Pavlik/STM32-WS2812B-Lamp/images/pcb-back-render.png

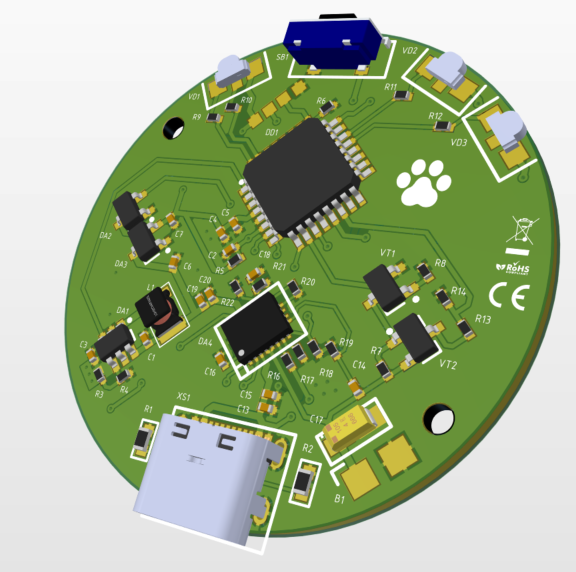
images/pcb-back-render.png
