Pavlik/STM32-WS2812B-Lamp/hardware/PCB/pics/ce.png

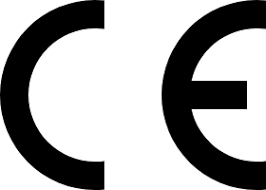
hardware/PCB/pics/ce.png
