Pavlik/STM32-WS2812B-Lamp/hardware/PCB/pics/paw.png

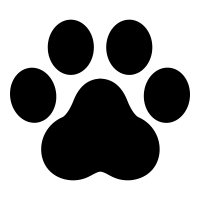
hardware/PCB/pics/paw.png
