Pavlik/STM32-WS2812B-Lamp/hardware/PCB/pics/rohs.png

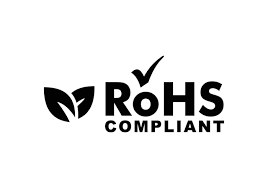
hardware/PCB/pics/rohs.png
