Pavlik/STM32-WS2812B-Lamp/hardware/PCB/pics/weee.png

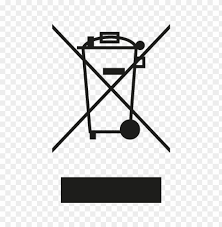
hardware/PCB/pics/weee.png
