Pavlik/STM32-WS2812B-Lamp/images/device-render-1.png

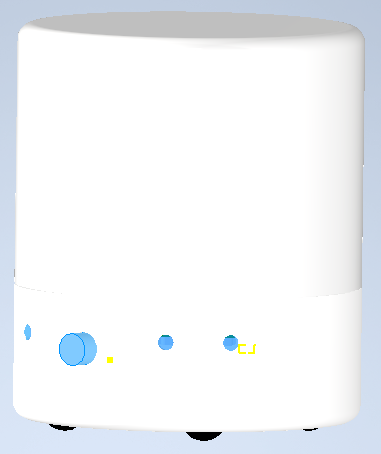
images/device-render-1.png
