Pavlik/STM32-WS2812B-Lamp/images/device-render-2.png

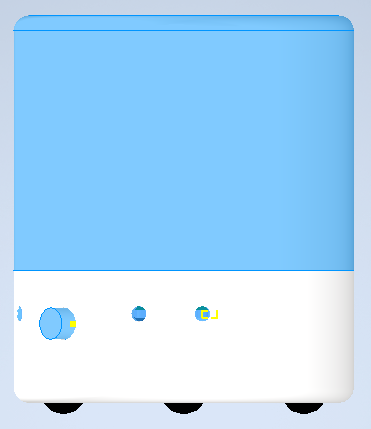
images/device-render-2.png
