Pavlik/STM32-WS2812B-Lamp/images/pcb-front-render.png

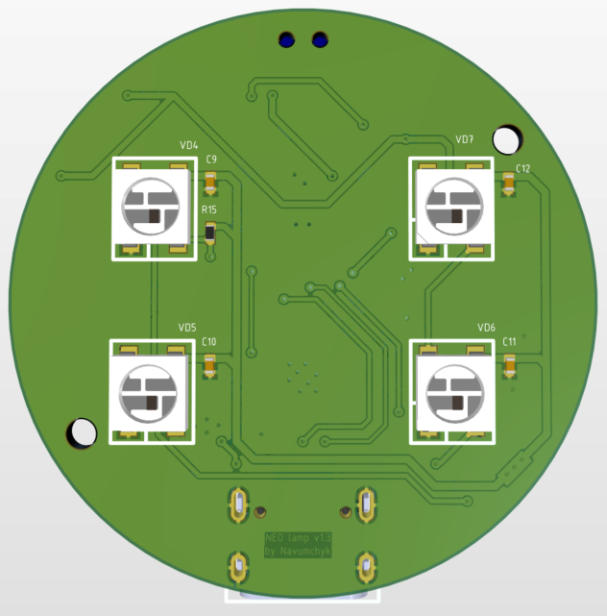
images/pcb-front-render.png
