Pavlik/STM32-WS2812B-Lamp/hardware/Schematics/BOM.pdf

Designator | Comment | Quantity | Note
B1 | LP502030 250mAh 3.7V | 1
C1, C3, C6, C7, C13, C19 | 10uF ±20% 0402 | 6
C2 | 1uF ±10% 0402 | 1
C4 | 4.7uF ±20% 0402 | 1
C5, C9, C10, C11, C12, C15, C16, C20 | 0.1uF ±10% 0402 | 8
C14, C18 | 0.22uF ±10% 0402 | 2
C17 | 100uF ±10% A 3216 | 1
DA1 | TPS61071 SOT23-6 | 1
DA2 | MAX809 SOT23-3 | 1 | Don't install
DA3 | XC6206P332MR SOT23-3 | 1
DA4 | BQ24070RHL VQFN20 (3.5*4.5) | 1
DD1 | STM32G030K6T6 LQFP32 | 1
L1 | LQH32CN100K23 10 uH ±20% | 1
R1, R2 | 5.1k ±1% 0603/0402 | 2
R3 | 1.8M ±5% 0402 | 1
R4 | 200k ±1% 0402 | 1
R5, R6, R13, R14, R15, R20 | 10k ±1% 0402 | 6 | Don't install R15 for FW v1.3
R7, R8, R16, R17, R18 | 100k ±1% 0402 | 5
R9, R10, R11, R12 | 1k ±1% 0402 | 4
R19 | 8.2k ±1% 0402 | 1
R21 | 37k ±1% 0402 | 1
R22 | 30k ±1% 0402 | 1
SB1 | KLS7-TS3606 | 1
VD1 | APBA3010SYKCGKC-GX | 1 | Yellow&Green
VD2, VD3 | KPA-3010SURC/KPA-3010QBC | 2 | Red or Blue
VD4, VD5, VD6, VD7 | ws2812b 5050 | 4
VT1 | BSS138 SOT23-3 | 1
VT2 | IRLML6402 SOT23-3 | 1
XS1 | TYPE-C 16PF-015 | 1
Created by Ochkaritus. | Project name: NEO_Lamp | Page 1
FW V1.3 | HW V1.3 | PCB v1.4 | NEO_LAMP_EM.BOM | 08.06.2026
