Pavlik/STM32-WS2812B-Lamp/hardware/PCB/3D models for PCB/Tant Cap SMD size A _ 3216-18.stp

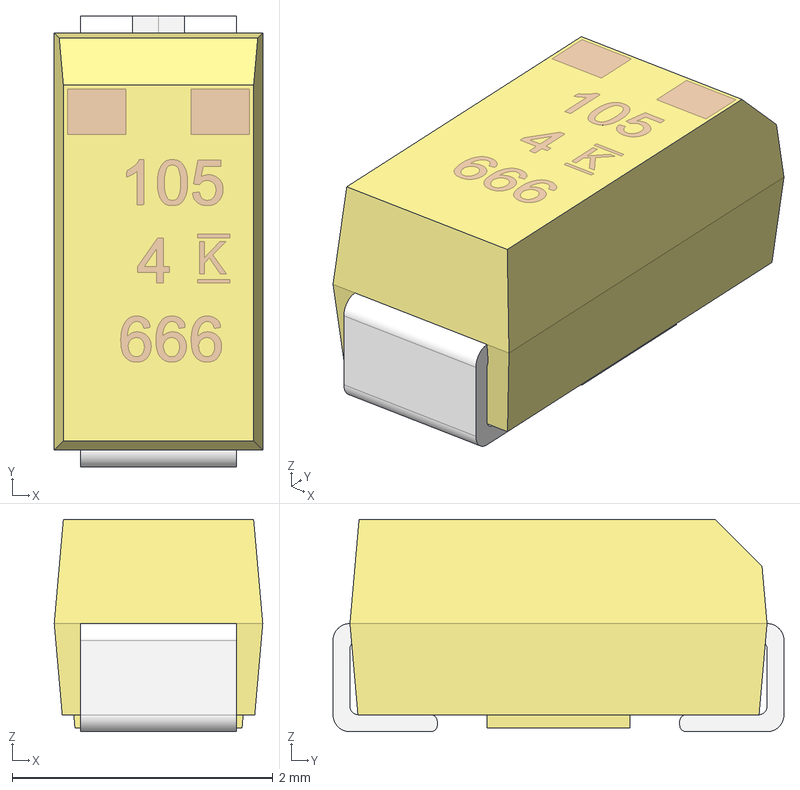
[picture p9: CAD file, 2026-10-11]
hardware/PCB/3D models for PCB/Tant Cap SMD size A _ 3216-18.stp
1.60 x 3.46 x 1.63 mm
