Pavlik/STM32-WS2812B-Lamp/hardware/PCB/NEO_LAMP/NEO_LAMP_PCB.step

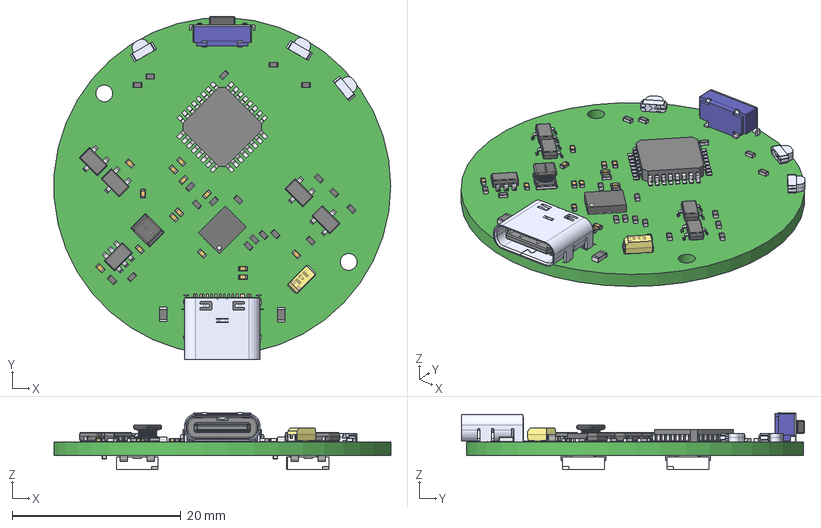
[picture p10: CAD file, 2026-10-11]
hardware/PCB/NEO_LAMP/NEO_LAMP_PCB.step
39.9 x 40.7 x 6.82 mm
Mid Body x 22
Mark x 22
USB C 16
Leader x 50
WS2812_RGB_LED_updated x 4
APBA3010 x 3
User Library-it-1188e_SW3dPS-E-Switch_-_TL3330AF130QG_(Tact_Switch,_SMD)
User Library-it-1188e_SW3dPS-E-Switch_-_TL3330AF130QG_(Tact_Switch,_SMD)001
User Library-it-1188e_SW3dPS-E-Switch_-_TL3330AF130QG_(Tact_Switch,_SMD)002
User Library-it-1188e_SW3dPS-E-Switch_-_TL3330AF130QG_(Tact_Switch,_SMD)003
User Library-it-1188e_SW3dPS-E-Switch_-_TL3330AF130QG_(Tact_Switch,_SMD)004
User Library-it-1188e_Fillet
User Library-it-1188e_Fillet001
LQH32CN4R7M23L
User Library-VQFN-20-2
