Pavlik/STM32-WS2812B-Lamp/hardware/PCB/3D models for PCB/APBA3010.stp

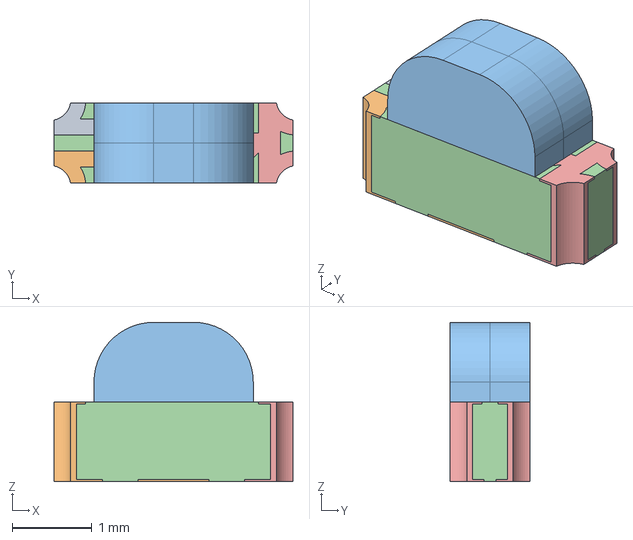
[picture p11: CAD file, 2026-10-11]
hardware/PCB/3D models for PCB/APBA3010.stp
3.00 x 1.00 x 2.00 mm
