Pavlik/STM32-WS2812B-Lamp/hardware/PCB/3D models for PCB/IT-1188E.STEP

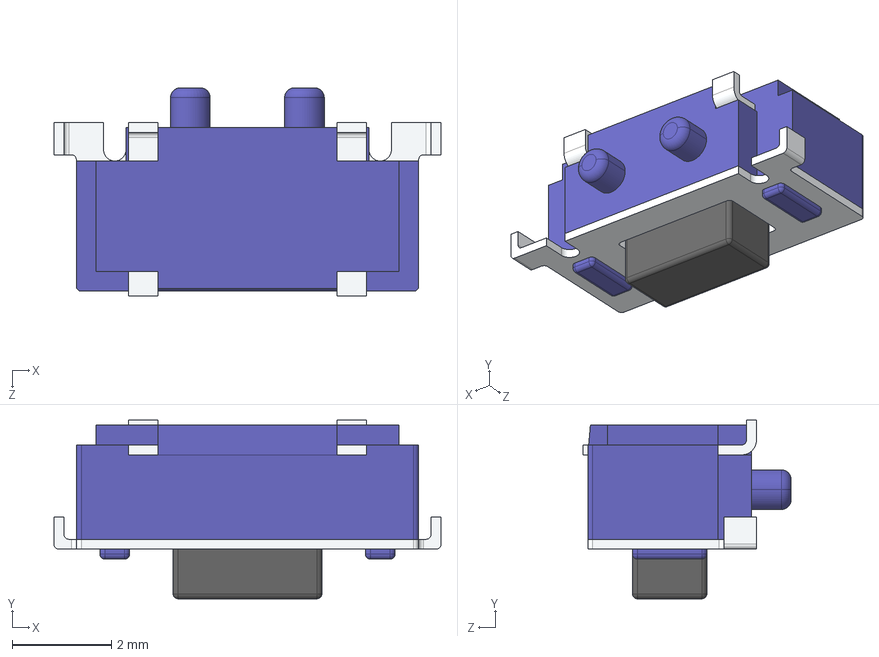
[picture p12: CAD file, 2026-10-11]
hardware/PCB/3D models for PCB/IT-1188E.STEP
7.80 x 3.60 x 4.20 mm
User Library-it-1188e_SW3dPS-E-Switch_-_TL3330AF130QG_(Tact_Switch,_SMD)
User Library-it-1188e_SW3dPS-E-Switch_-_TL3330AF130QG_(Tact_Switch,_SMD)001
User Library-it-1188e_SW3dPS-E-Switch_-_TL3330AF130QG_(Tact_Switch,_SMD)002
User Library-it-1188e_SW3dPS-E-Switch_-_TL3330AF130QG_(Tact_Switch,_SMD)003
User Library-it-1188e_SW3dPS-E-Switch_-_TL3330AF130QG_(Tact_Switch,_SMD)004
User Library-it-1188e_Fillet
User Library-it-1188e_Fillet001
