Pavlik/STM32-WS2812B-Lamp/hardware/PCB/3D models for PCB/User Library-VQFN-20-2.step

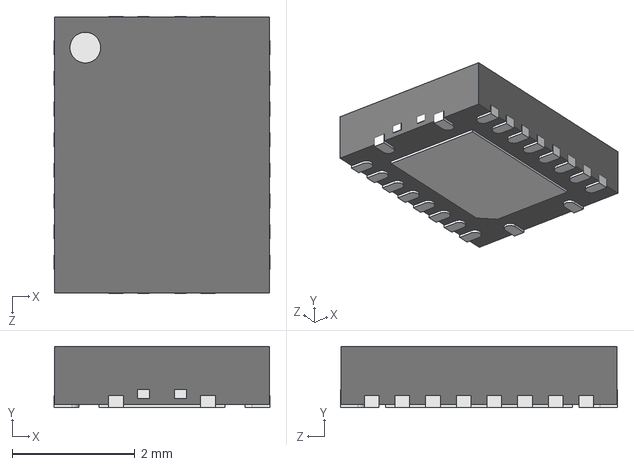
[picture p13: CAD file, 2026-10-11]
hardware/PCB/3D models for PCB/User Library-VQFN-20-2.step
3.52 x 1.00 x 4.52 mm
