Pavlik/STM32-WS2812B-Lamp/(list of files, cad)

Other CAD files:
hardware/PCB/NEO_LAMP/PCB_v1.step
hardware/PCB/3D models for PCB/APBA3010 (1).sldprt
enclosure/base.ipt
enclosure/light diffuser short.ipt
enclosure/light diffuser.ipt
enclosure/light guide.ipt
enclosure/pusher.ipt
hardware/PCB/3D models for PCB/APBA3010 (1)/APBA3010 (1).ipt
hardware/PCB/3D models for PCB/APBA3010 (1)/OldVersions/APBA3010 (1).0001.ipt
hardware/PCB/NEO_LAMP/NEO_LAMP_PCB/6213788400.iam
hardware/PCB/NEO_LAMP/NEO_LAMP_PCB/6213788480.iam
hardware/PCB/NEO_LAMP/NEO_LAMP_PCB/6213788640.iam
hardware/PCB/NEO_LAMP/NEO_LAMP_PCB/6213788800.iam
hardware/PCB/NEO_LAMP/NEO_LAMP_PCB/6213788960.iam
hardware/PCB/NEO_LAMP/NEO_LAMP_PCB/6213789200.iam
hardware/PCB/NEO_LAMP/NEO_LAMP_PCB/6213789280.iam
hardware/PCB/NEO_LAMP/NEO_LAMP_PCB/6213789360.iam
hardware/PCB/NEO_LAMP/NEO_LAMP_PCB/6213789520.iam
hardware/PCB/NEO_LAMP/NEO_LAMP_PCB/6213789680.iam
hardware/PCB/NEO_LAMP/NEO_LAMP_PCB/6213790000.iam
hardware/PCB/NEO_LAMP/NEO_LAMP_PCB/6213790240.iam
hardware/PCB/NEO_LAMP/NEO_LAMP_PCB/6213790400.iam
hardware/PCB/NEO_LAMP/NEO_LAMP_PCB/6213790640.iam
hardware/PCB/NEO_LAMP/NEO_LAMP_PCB/6213790800.iam
hardware/PCB/NEO_LAMP/NEO_LAMP_PCB/6213790880.iam
hardware/PCB/NEO_LAMP/NEO_LAMP_PCB/6213790960.iam
hardware/PCB/NEO_LAMP/NEO_LAMP_PCB/6213791120.iam
hardware/PCB/NEO_LAMP/NEO_LAMP_PCB/APBA3010.ipt
hardware/PCB/NEO_LAMP/NEO_LAMP_PCB/Board.iam
hardware/PCB/NEO_LAMP/NEO_LAMP_PCB/Body.iam
hardware/PCB/NEO_LAMP/NEO_LAMP_PCB/Body_1.iam
hardware/PCB/NEO_LAMP/NEO_LAMP_PCB/Body_2.iam
hardware/PCB/NEO_LAMP/NEO_LAMP_PCB/Body_3.iam
hardware/PCB/NEO_LAMP/NEO_LAMP_PCB/C1.iam
hardware/PCB/NEO_LAMP/NEO_LAMP_PCB/C10.iam
hardware/PCB/NEO_LAMP/NEO_LAMP_PCB/C11.iam
hardware/PCB/NEO_LAMP/NEO_LAMP_PCB/C12.iam
hardware/PCB/NEO_LAMP/NEO_LAMP_PCB/C13.iam
hardware/PCB/NEO_LAMP/NEO_LAMP_PCB/C14.iam
hardware/PCB/NEO_LAMP/NEO_LAMP_PCB/C15.iam
hardware/PCB/NEO_LAMP/NEO_LAMP_PCB/C16.iam
hardware/PCB/NEO_LAMP/NEO_LAMP_PCB/C17.iam
hardware/PCB/NEO_LAMP/NEO_LAMP_PCB/C18.iam
hardware/PCB/NEO_LAMP/NEO_LAMP_PCB/C19.iam
hardware/PCB/NEO_LAMP/NEO_LAMP_PCB/C2.iam
hardware/PCB/NEO_LAMP/NEO_LAMP_PCB/C20.iam
hardware/PCB/NEO_LAMP/NEO_LAMP_PCB/C3.iam
hardware/PCB/NEO_LAMP/NEO_LAMP_PCB/C4.iam
hardware/PCB/NEO_LAMP/NEO_LAMP_PCB/C5.iam
hardware/PCB/NEO_LAMP/NEO_LAMP_PCB/C6.iam
hardware/PCB/NEO_LAMP/NEO_LAMP_PCB/C7.iam
hardware/PCB/NEO_LAMP/NEO_LAMP_PCB/C9.iam
hardware/PCB/NEO_LAMP/NEO_LAMP_PCB/DA1.iam
hardware/PCB/NEO_LAMP/NEO_LAMP_PCB/DA2.iam
hardware/PCB/NEO_LAMP/NEO_LAMP_PCB/DA3.iam
hardware/PCB/NEO_LAMP/NEO_LAMP_PCB/DA4.iam
hardware/PCB/NEO_LAMP/NEO_LAMP_PCB/DD1.iam
hardware/PCB/NEO_LAMP/NEO_LAMP_PCB/IT-1188E.iam
hardware/PCB/NEO_LAMP/NEO_LAMP_PCB/L1.iam
hardware/PCB/NEO_LAMP/NEO_LAMP_PCB/LQH32CN4R7M23L.ipt
hardware/PCB/NEO_LAMP/NEO_LAMP_PCB/Leader.ipt
hardware/PCB/NEO_LAMP/NEO_LAMP_PCB/Leader_1.ipt
hardware/PCB/NEO_LAMP/NEO_LAMP_PCB/Leader_2.ipt
hardware/PCB/NEO_LAMP/NEO_LAMP_PCB/Leader_3.ipt
hardware/PCB/NEO_LAMP/NEO_LAMP_PCB/Mark.ipt
hardware/PCB/NEO_LAMP/NEO_LAMP_PCB/Mark_1.ipt
hardware/PCB/NEO_LAMP/NEO_LAMP_PCB/Mark_2.ipt
hardware/PCB/NEO_LAMP/NEO_LAMP_PCB/Mark_3.ipt
hardware/PCB/NEO_LAMP/NEO_LAMP_PCB/Mark_4.ipt
hardware/PCB/NEO_LAMP/NEO_LAMP_PCB/Mark_5.ipt
hardware/PCB/NEO_LAMP/NEO_LAMP_PCB/Mark_6.ipt
hardware/PCB/NEO_LAMP/NEO_LAMP_PCB/Mark_7.ipt
hardware/PCB/NEO_LAMP/NEO_LAMP_PCB/Mid Body.iam
hardware/PCB/NEO_LAMP/NEO_LAMP_PCB/Mid Body.ipt
hardware/PCB/NEO_LAMP/NEO_LAMP_PCB/Mid Body_1.iam
hardware/PCB/NEO_LAMP/NEO_LAMP_PCB/Mid Body_1.ipt
hardware/PCB/NEO_LAMP/NEO_LAMP_PCB/Mid Body_2.iam
hardware/PCB/NEO_LAMP/NEO_LAMP_PCB/Mid Body_2.ipt
hardware/PCB/NEO_LAMP/NEO_LAMP_PCB/Mid Body_3.iam
hardware/PCB/NEO_LAMP/NEO_LAMP_PCB/Mid Body_3.ipt
hardware/PCB/NEO_LAMP/NEO_LAMP_PCB/Mid Body_4.iam
hardware/PCB/NEO_LAMP/NEO_LAMP_PCB/Mid Body_4.ipt
hardware/PCB/NEO_LAMP/NEO_LAMP_PCB/Mid Body_5.iam
hardware/PCB/NEO_LAMP/NEO_LAMP_PCB/Mid Body_5.ipt
hardware/PCB/NEO_LAMP/NEO_LAMP_PCB/Mid Body_6.ipt
hardware/PCB/NEO_LAMP/NEO_LAMP_PCB/Mid Body_7.ipt
hardware/PCB/NEO_LAMP/NEO_LAMP_PCB/NEO_LAMP_PCB.iam
hardware/PCB/NEO_LAMP/NEO_LAMP_PCB/Open CASCADE STEP translator 7.5 1.1.1.ipt
hardware/PCB/NEO_LAMP/NEO_LAMP_PCB/Open CASCADE STEP translator 7.5 1.44.1.1.ipt
hardware/PCB/NEO_LAMP/NEO_LAMP_PCB/Open CASCADE STEP translator 7.5 1.44.1.2.ipt
hardware/PCB/NEO_LAMP/NEO_LAMP_PCB/Open CASCADE STEP translator 7.5 2.2.1.ipt
hardware/PCB/NEO_LAMP/NEO_LAMP_PCB/Open CASCADE STEP translator 7.5 2.2.1_1.ipt
hardware/PCB/NEO_LAMP/NEO_LAMP_PCB/Open CASCADE STEP translator 7.5 2.2.1_2.ipt
hardware/PCB/NEO_LAMP/NEO_LAMP_PCB/Open CASCADE STEP translator 7.5 2.2.1_3.ipt
hardware/PCB/NEO_LAMP/NEO_LAMP_PCB/Open CASCADE STEP translator 7.5 2.2.1_4.ipt
hardware/PCB/NEO_LAMP/NEO_LAMP_PCB/Open CASCADE STEP translator 7.5 2.2.1_5.ipt
hardware/PCB/NEO_LAMP/NEO_LAMP_PCB/Open CASCADE STEP translator 7.5 2.2.1_6.ipt
hardware/PCB/NEO_LAMP/NEO_LAMP_PCB/Open CASCADE STEP translator 7.5 23.1.1.ipt
hardware/PCB/NEO_LAMP/NEO_LAMP_PCB/Open CASCADE STEP translator 7.5 23.1.1_1.ipt
hardware/PCB/NEO_LAMP/NEO_LAMP_PCB/Open CASCADE STEP translator 7.5 23.1.1_2.ipt
hardware/PCB/NEO_LAMP/NEO_LAMP_PCB/Open CASCADE STEP translator 7.5 23.1.1_3.ipt
hardware/PCB/NEO_LAMP/NEO_LAMP_PCB/Open CASCADE STEP translator 7.5 23.1.1_4.ipt
hardware/PCB/NEO_LAMP/NEO_LAMP_PCB/Open CASCADE STEP translator 7.5 23.1.1_5.ipt
hardware/PCB/NEO_LAMP/NEO_LAMP_PCB/Open CASCADE STEP translator 7.5 23.1.2.ipt
hardware/PCB/NEO_LAMP/NEO_LAMP_PCB/Open CASCADE STEP translator 7.5 23.1.2_1.ipt
hardware/PCB/NEO_LAMP/NEO_LAMP_PCB/Open CASCADE STEP translator 7.5 23.1.2_2.ipt
hardware/PCB/NEO_LAMP/NEO_LAMP_PCB/Open CASCADE STEP translator 7.5 23.1.2_3.ipt
hardware/PCB/NEO_LAMP/NEO_LAMP_PCB/Open CASCADE STEP translator 7.5 23.1.2_4.ipt
hardware/PCB/NEO_LAMP/NEO_LAMP_PCB/Open CASCADE STEP translator 7.5 23.1.2_5.ipt
hardware/PCB/NEO_LAMP/NEO_LAMP_PCB/Open CASCADE STEP translator 7.5 23.2.1.ipt
hardware/PCB/NEO_LAMP/NEO_LAMP_PCB/Open CASCADE STEP translator 7.5 23.2.1_1.ipt
hardware/PCB/NEO_LAMP/NEO_LAMP_PCB/Open CASCADE STEP translator 7.5 23.2.1_2.ipt
hardware/PCB/NEO_LAMP/NEO_LAMP_PCB/Open CASCADE STEP translator 7.5 23.2.1_3.ipt
hardware/PCB/NEO_LAMP/NEO_LAMP_PCB/Open CASCADE STEP translator 7.5 23.2.1_4.ipt
hardware/PCB/NEO_LAMP/NEO_LAMP_PCB/Open CASCADE STEP translator 7.5 23.2.1_5.ipt
hardware/PCB/NEO_LAMP/NEO_LAMP_PCB/Open CASCADE STEP translator 7.5 7.2.1.ipt
hardware/PCB/NEO_LAMP/NEO_LAMP_PCB/Open CASCADE STEP translator 7.5 79.1.1.ipt
hardware/PCB/NEO_LAMP/NEO_LAMP_PCB/Open CASCADE STEP translator 7.5 82.1.1.ipt
hardware/PCB/NEO_LAMP/NEO_LAMP_PCB/Open CASCADE STEP translator 7.5 84.1.1.ipt
hardware/PCB/NEO_LAMP/NEO_LAMP_PCB/Open CASCADE STEP translator 7.5 84.1.1_1.ipt
hardware/PCB/NEO_LAMP/NEO_LAMP_PCB/R1.iam
hardware/PCB/NEO_LAMP/NEO_LAMP_PCB/R10.iam
hardware/PCB/NEO_LAMP/NEO_LAMP_PCB/R11.iam
hardware/PCB/NEO_LAMP/NEO_LAMP_PCB/R12.iam
hardware/PCB/NEO_LAMP/NEO_LAMP_PCB/R13.iam
hardware/PCB/NEO_LAMP/NEO_LAMP_PCB/R14.iam
hardware/PCB/NEO_LAMP/NEO_LAMP_PCB/R15.iam
hardware/PCB/NEO_LAMP/NEO_LAMP_PCB/R16.iam
hardware/PCB/NEO_LAMP/NEO_LAMP_PCB/R17.iam
hardware/PCB/NEO_LAMP/NEO_LAMP_PCB/R18.iam
hardware/PCB/NEO_LAMP/NEO_LAMP_PCB/R19.iam
hardware/PCB/NEO_LAMP/NEO_LAMP_PCB/R2.iam
hardware/PCB/NEO_LAMP/NEO_LAMP_PCB/R20.iam
hardware/PCB/NEO_LAMP/NEO_LAMP_PCB/R21.iam
hardware/PCB/NEO_LAMP/NEO_LAMP_PCB/R22.iam
hardware/PCB/NEO_LAMP/NEO_LAMP_PCB/R3.iam
hardware/PCB/NEO_LAMP/NEO_LAMP_PCB/R4.iam
hardware/PCB/NEO_LAMP/NEO_LAMP_PCB/R5.iam
hardware/PCB/NEO_LAMP/NEO_LAMP_PCB/R6.iam
hardware/PCB/NEO_LAMP/NEO_LAMP_PCB/R7.iam
hardware/PCB/NEO_LAMP/NEO_LAMP_PCB/R8.iam
hardware/PCB/NEO_LAMP/NEO_LAMP_PCB/R9.iam
hardware/PCB/NEO_LAMP/NEO_LAMP_PCB/SB1.iam
hardware/PCB/NEO_LAMP/NEO_LAMP_PCB/Tant Cap SMD size A _ 3216-18.iam
hardware/PCB/NEO_LAMP/NEO_LAMP_PCB/Terminal.iam
hardware/PCB/NEO_LAMP/NEO_LAMP_PCB/Terminal_1.iam
hardware/PCB/NEO_LAMP/NEO_LAMP_PCB/Terminal_10.iam
hardware/PCB/NEO_LAMP/NEO_LAMP_PCB/Terminal_11.iam
hardware/PCB/NEO_LAMP/NEO_LAMP_PCB/Terminal_12.iam
hardware/PCB/NEO_LAMP/NEO_LAMP_PCB/Terminal_13.iam
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
