Pavlik/STM32-WS2812B-Lamp/hardware/Schematics/Assembly_drawing.PDF

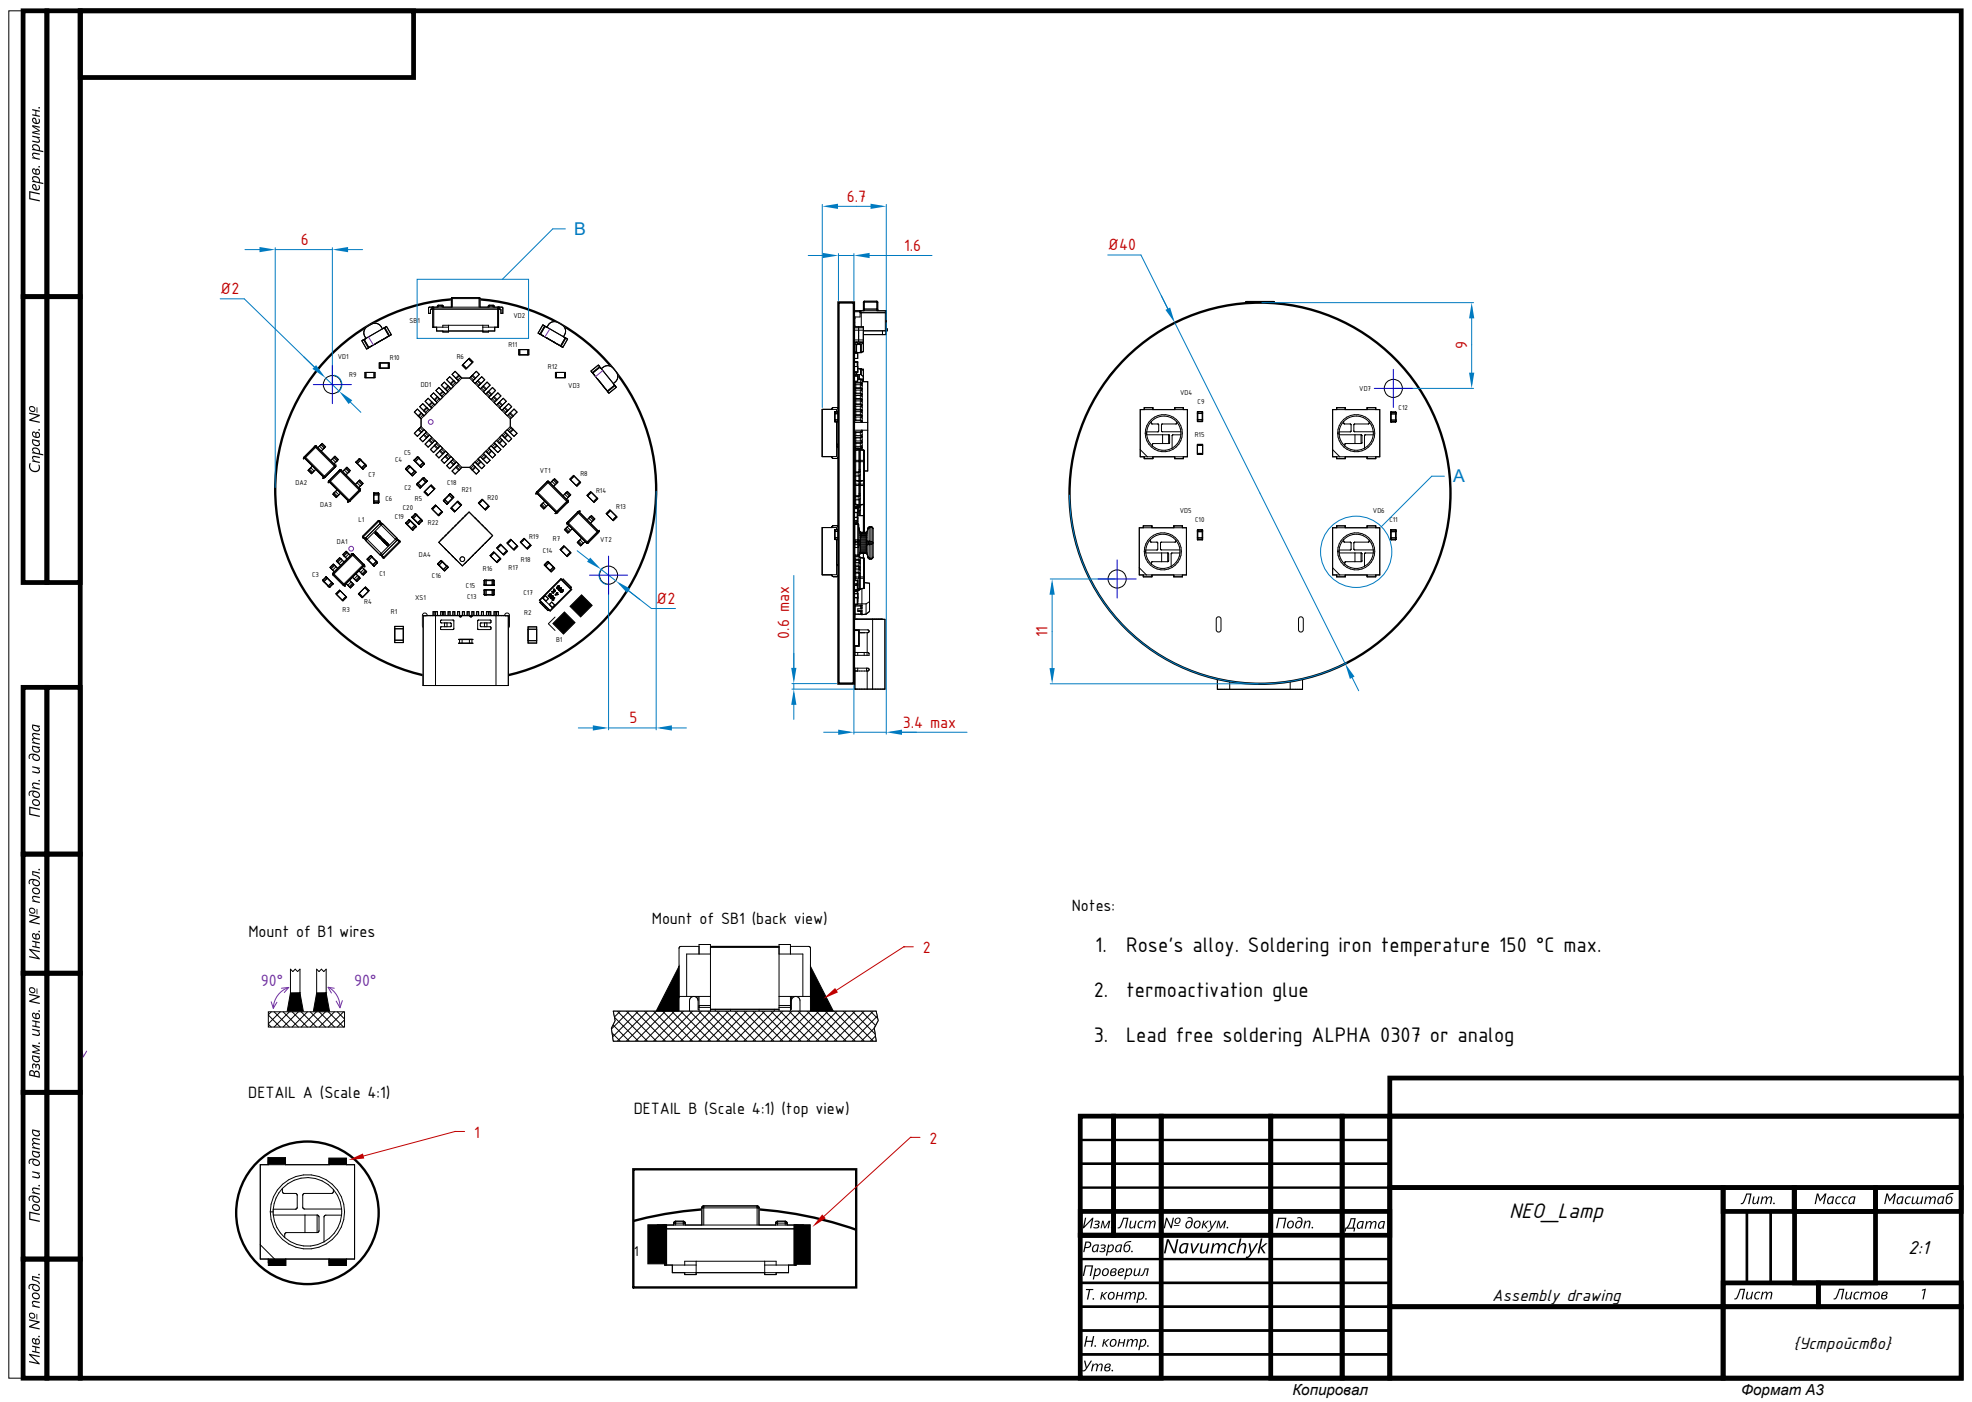
[picture p14: page 1]

Notes:
1. Rose's alloy. Soldering iron temperature 150 °C max.
2. termoactivation glue
3. Lead free soldering ALPHA 0307 or analog

Mount of SB1 (back view)

DETAIL B (Scale 4:1) (top view)
