Pavlik/STM32-WS2812B-Lamp/hardware/Schematics/Schematics.PDF

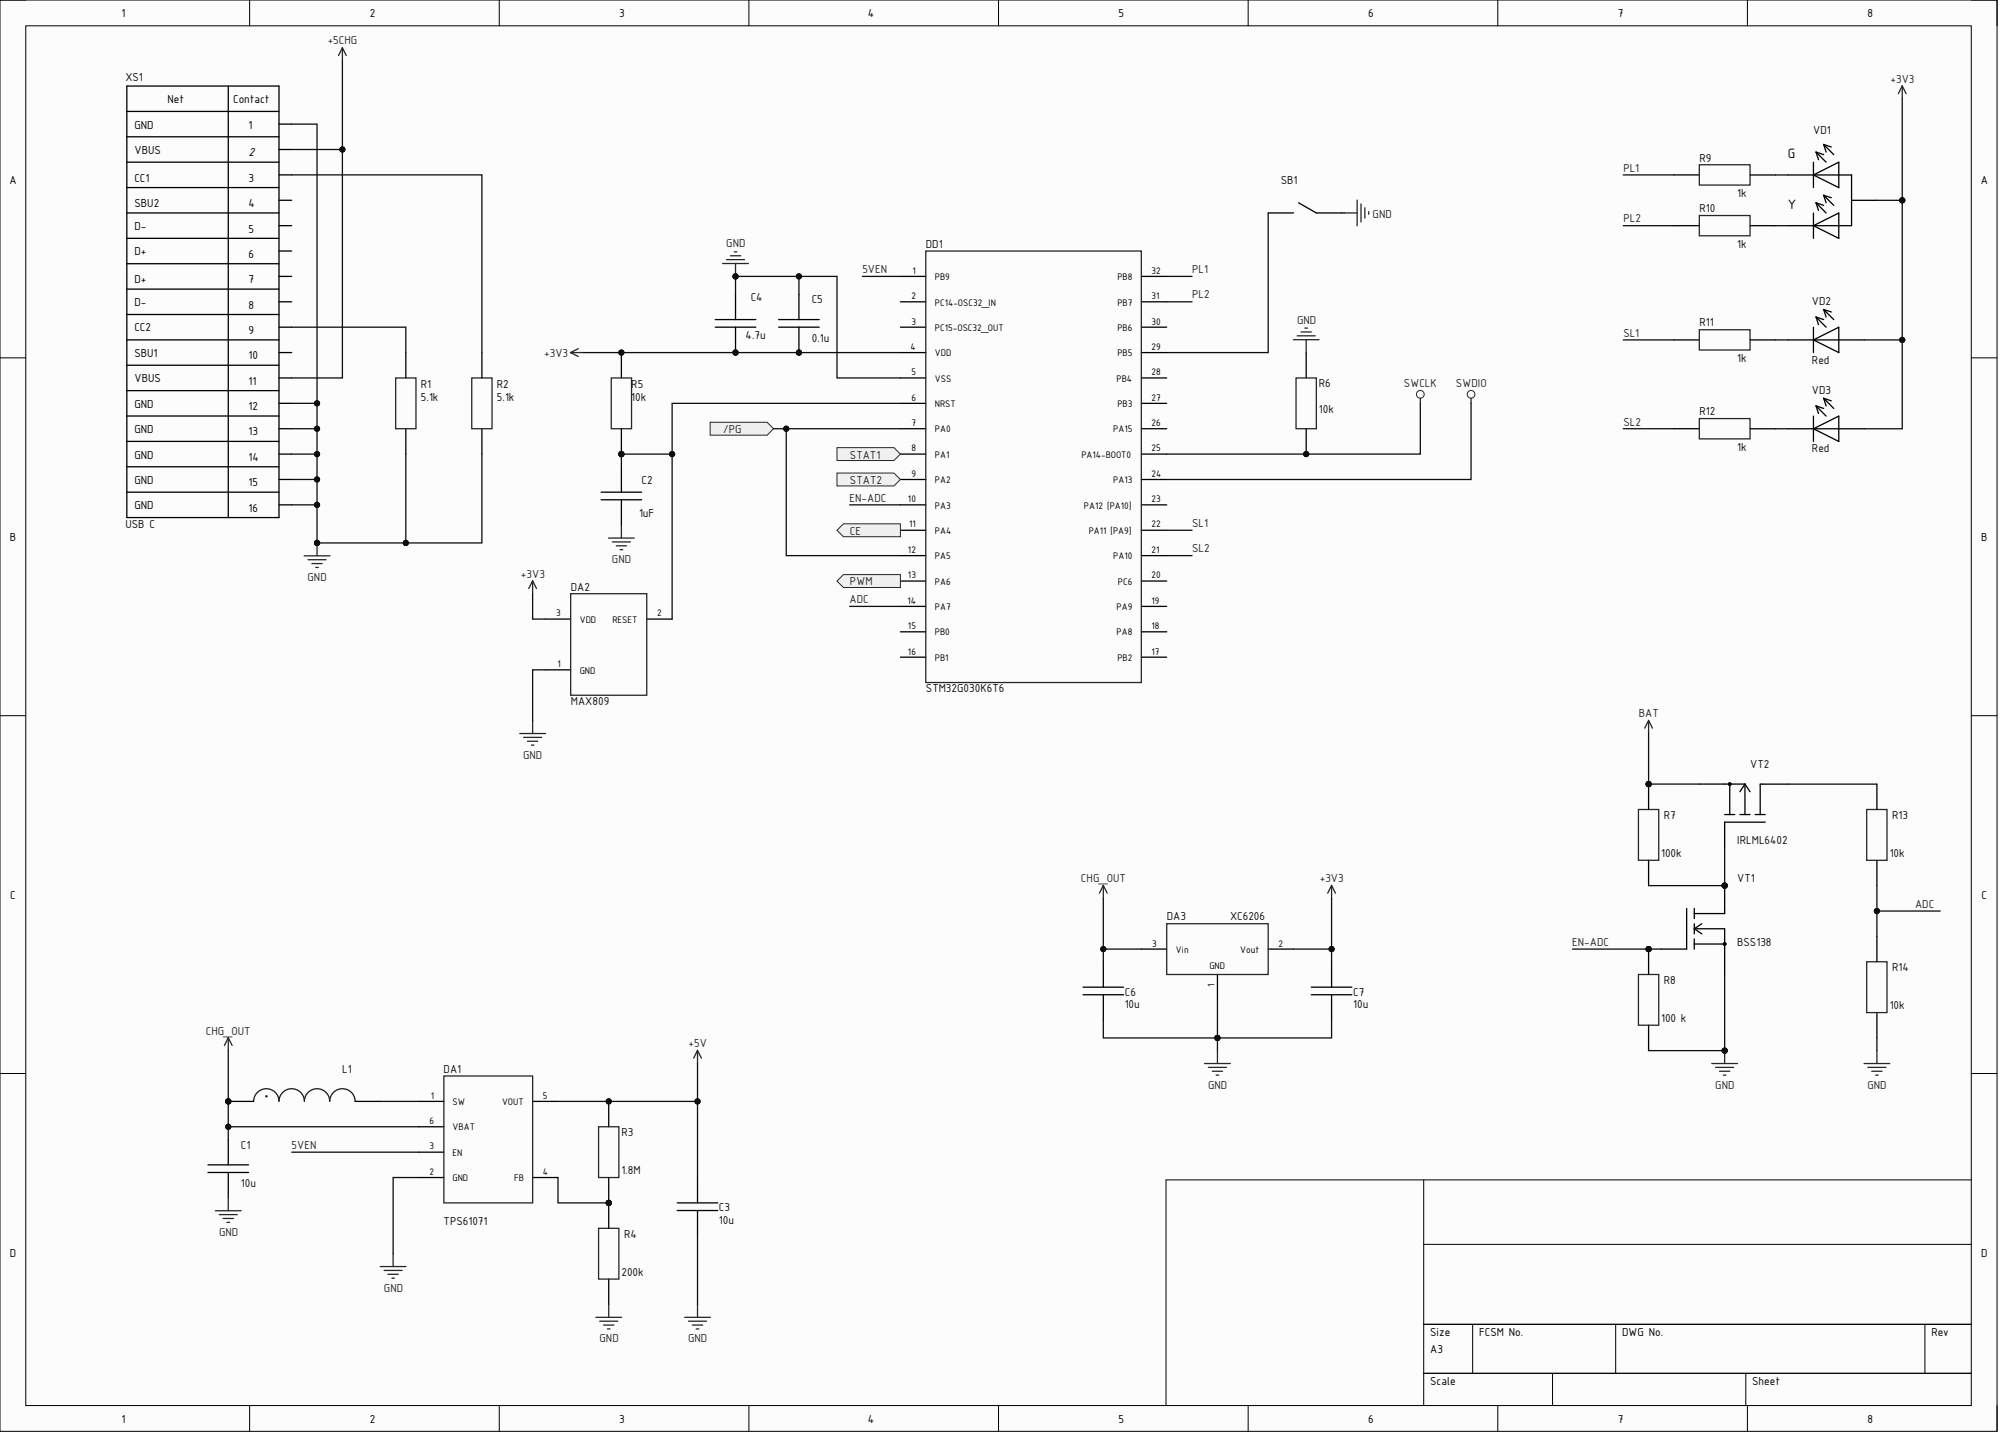
[picture p15: page 1]

Net | Conta с t

GND

VBUS

SBU1

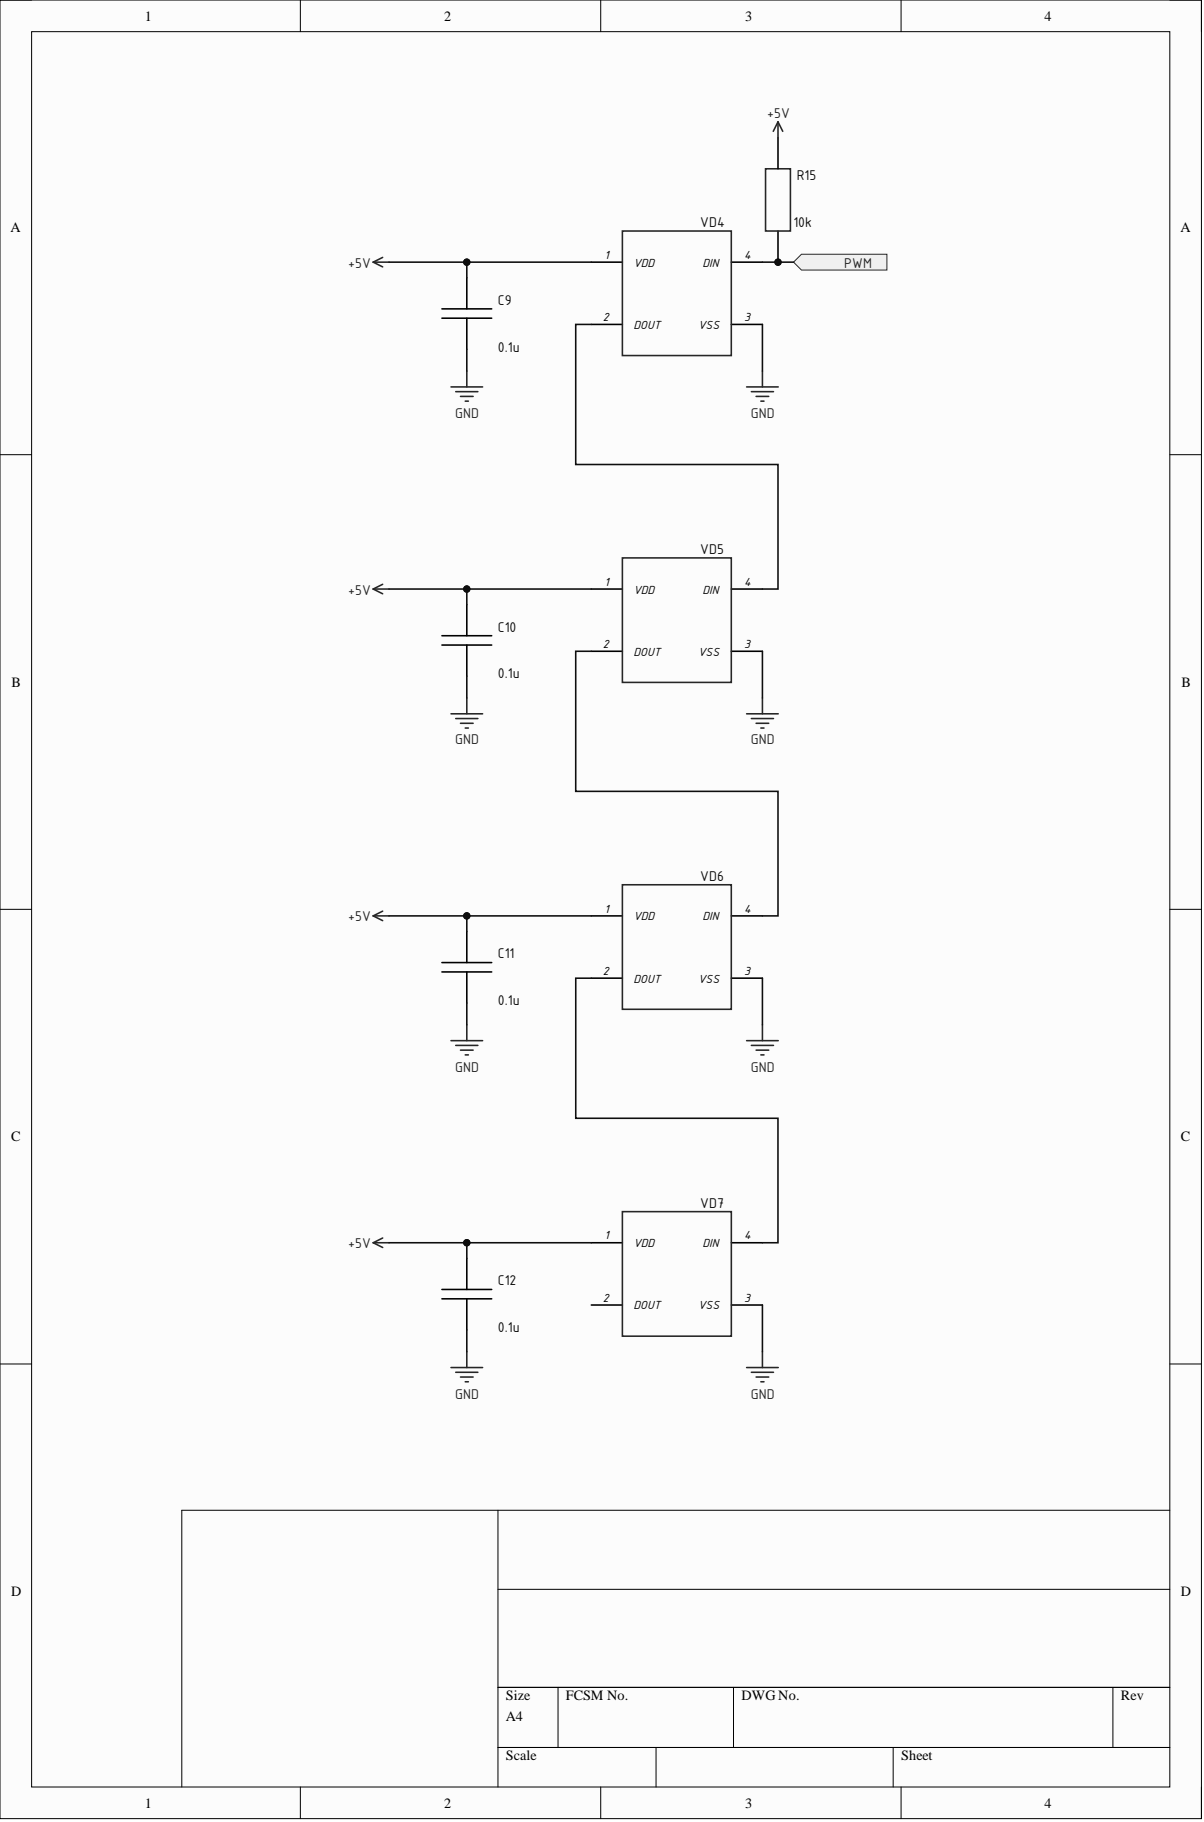
[picture p16: page 2]

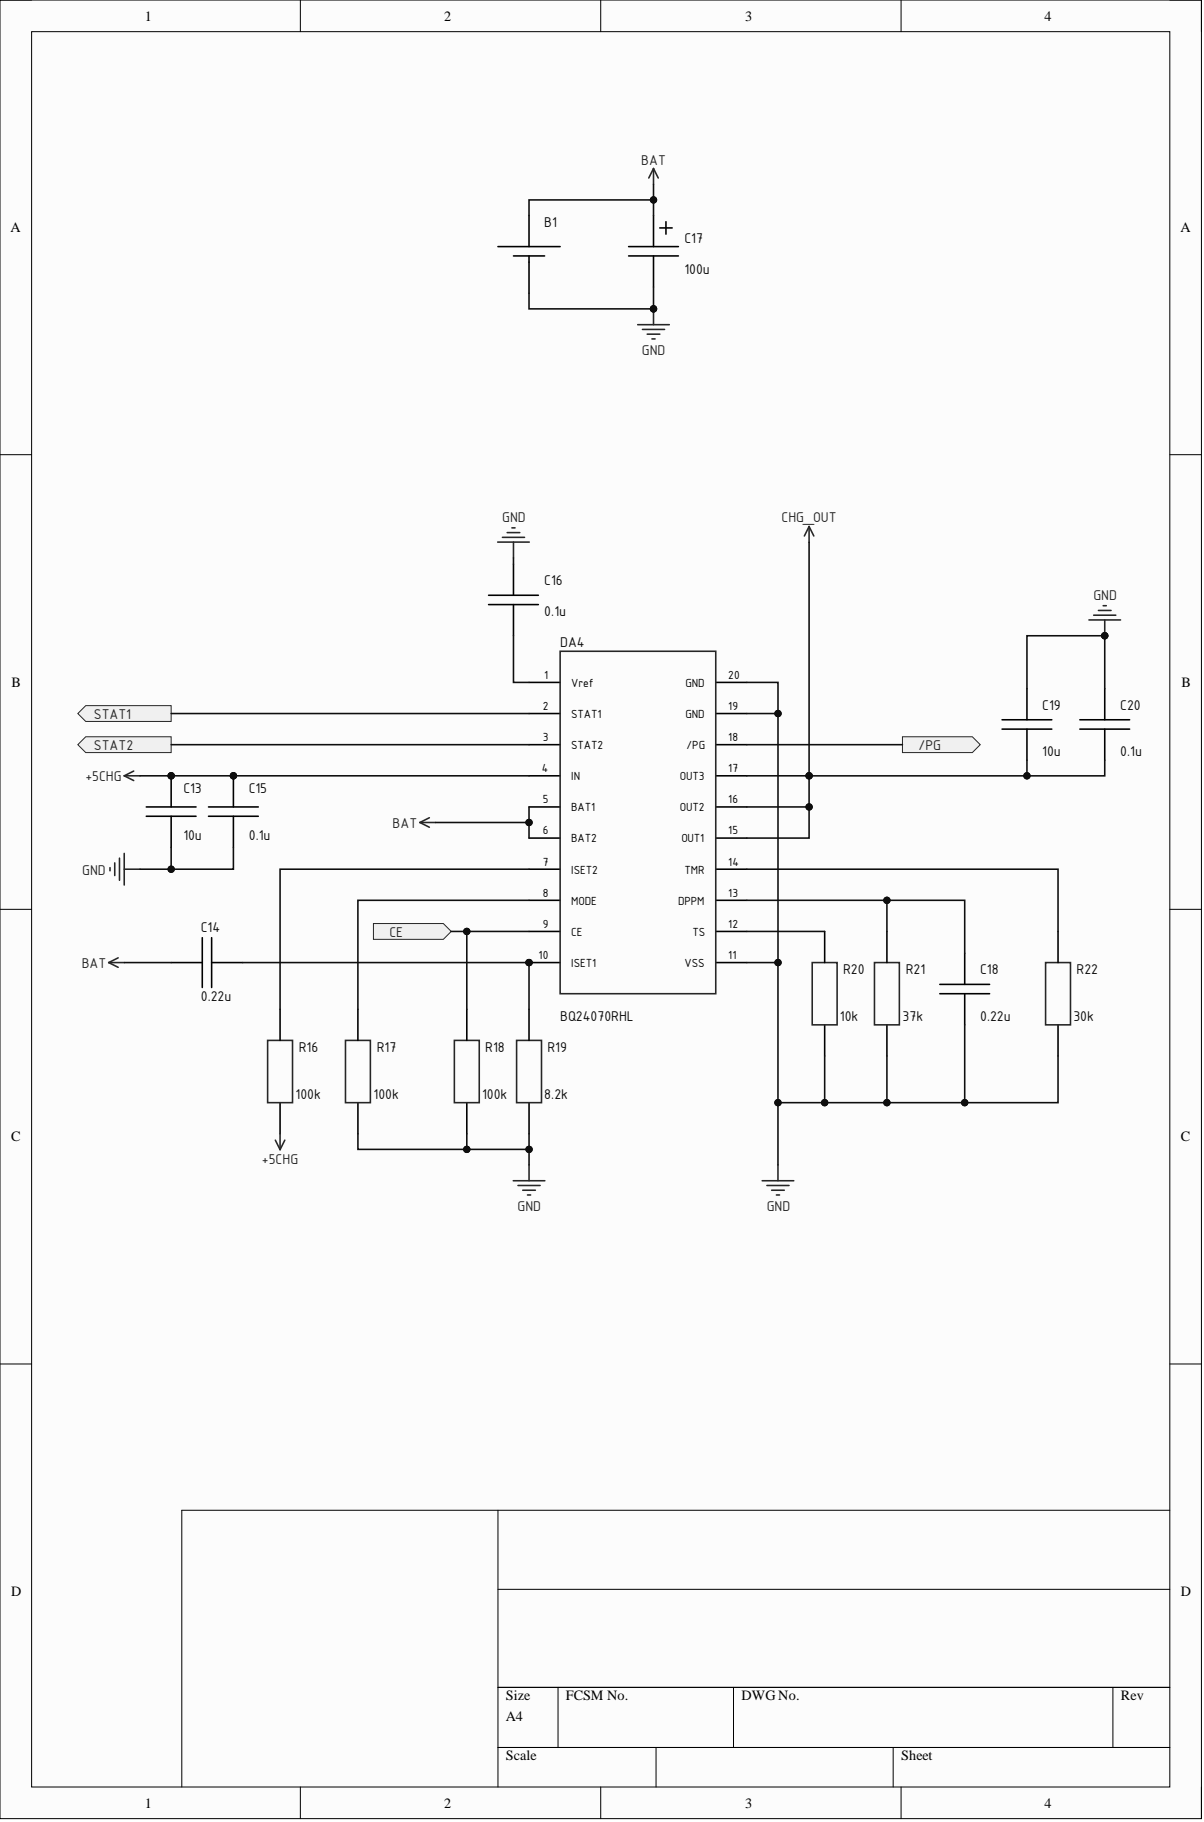
[picture p17: page 3]
