Pavlik/STM32-WS2812B-Lamp/(list of files, drawings)

Other design files:
hardware/PCB/liba/for_Lamp.PcbLib
hardware/PCB/liba/for_Lamp.SchLib
hardware/PCB/NEO_LAMP/charge_block.SchDoc
hardware/PCB/NEO_LAMP/Control block.SchDoc
hardware/PCB/NEO_LAMP/LEDS.SchDoc
hardware/PCB/NEO_LAMP/NEO_LAMP.PrjPcb
hardware/PCB/NEO_LAMP/NEO_LAMP_PCB.PcbDoc
