Pavlik/STM32-WS2812B-Lamp/firmware/Neo_lamp.ioc

Mcu.UserName=STM32G030K6Tx
PA13.Signal=SYS_SWDIO
PA14-BOOT0.Signal=SYS_SWCLK
