Pavlik/STM32-WS2812B-Lamp/(commit log)

2026-10-11 add STM32CubeIDE project configuratuin. Add the code of whole project
2026-10-11 add schematics, assembly drawing of pcb and BOM
2026-10-11 add pcb files
2026-10-11 add enclosure
